AlmCoding/modbus-hbridge/modbus-hbridge-3d/case-top-Body.stl

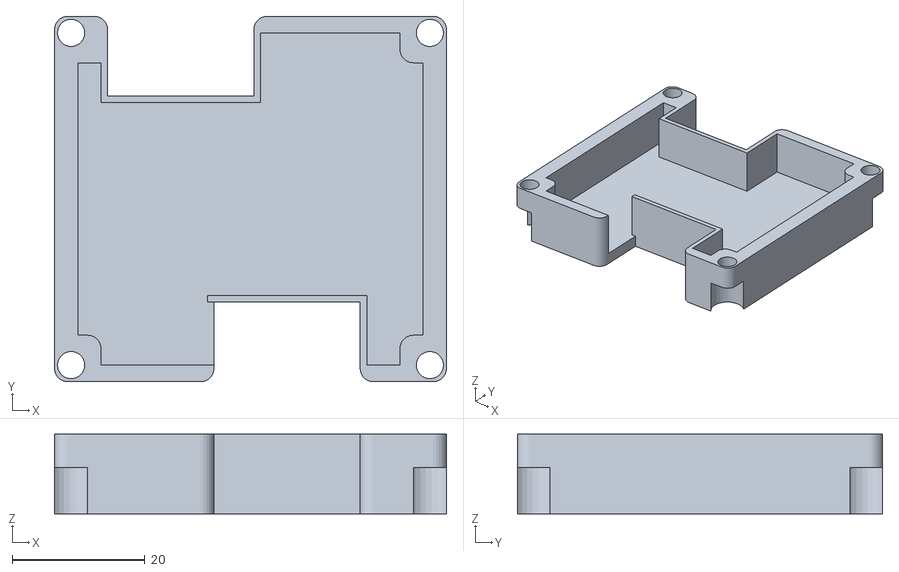
[picture p2: CAD file, 2026-10-08]
modbus-hbridge-3d/case-top-Body.stl
59.0 x 55.0 x 12.0
