AlmCoding/modbus-hbridge/modbus-hbridge-3d/case-bottom-Body.stl

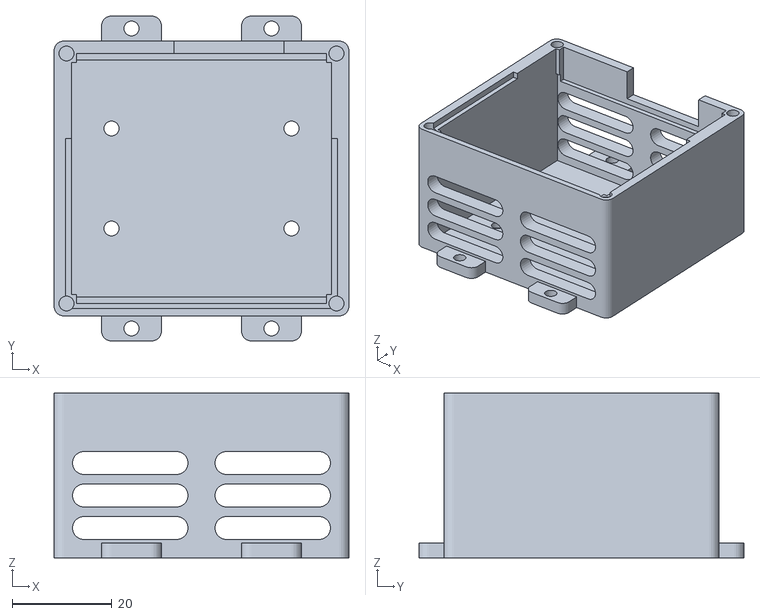
[picture p3: CAD file, 2026-10-08]
modbus-hbridge-3d/case-bottom-Body.stl
59.0 x 65.0 x 33.0
