AlmCoding/modbus-hbridge/(list of files, cad)

Other CAD files:
modbus-hbridge-3d/case-top.FCStd
modbus-hbridge-3d/case-bottom.FCStd
