AlmCoding/modbus-hbridge/modbus-hbridge-hw/modbus-hbridge-hw.kicad_pcb

## KiCad design modbus-hbridge-hw/modbus-hbridge-hw.kicad_pcb (2026-10-08)

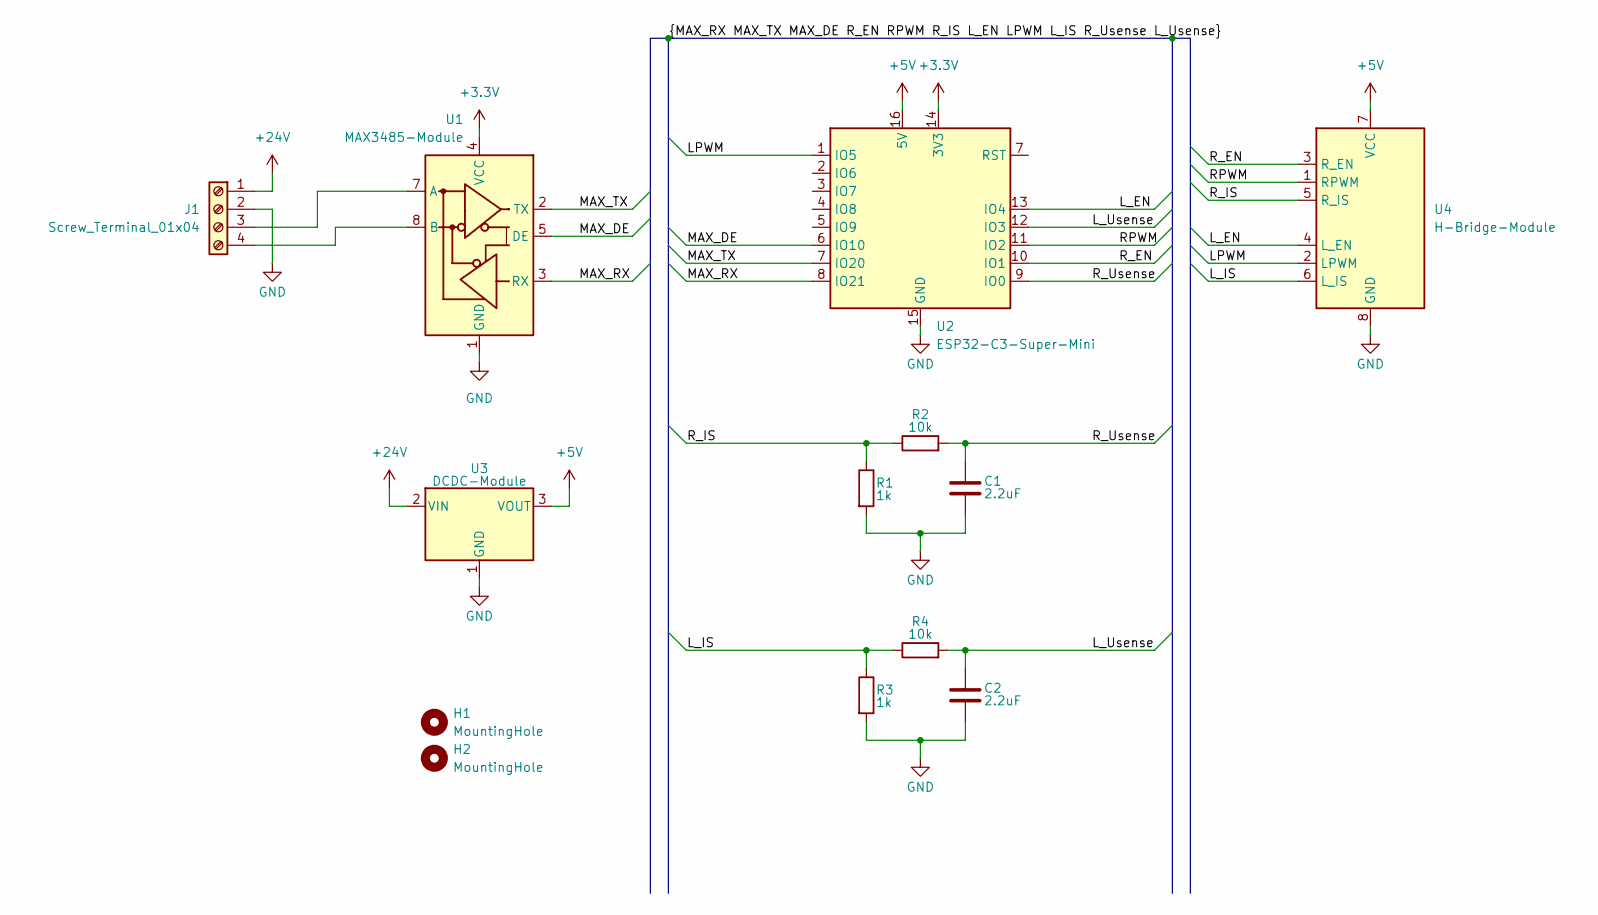
[picture p4: schematic modbus-hbridge-hw.kicad_sch]

Parts:
C1, C2: 2.2uF; C_0603_1608Metric_Pad1.08x0.95mm_HandSolder
H1, H2: MountingHole; MountingHole_3.2mm_M3
J1: Screw_Terminal_01x04; TerminalBlock_CUI_TB007-508-04_1x04_P5.08mm_Horizontal
R1, R3: 1k; R_0603_1608Metric_Pad0.98x0.95mm_HandSolder
R2, R4: 10k; R_0603_1608Metric_Pad0.98x0.95mm_HandSolder
U1: MAX3485-Module
U2: ESP32-C3-Super-Mini; ESP32-C3-SuperMini
U3: DCDC-Module; DCDC-Module-S
U4: H-Bridge-Module

Connections:
+3.3V: U1.4 (VCC), U2.14 (3V3)
+5V: U2.16 (5V), U3.3 (VOUT), U4.7 (VCC)
+24V: J1.1, U3.2 (VIN)
/LPWM: U2.1 (IO5), U4.2 (LPWM)
/L_EN: U2.13 (IO4), U4.4 (L_EN)
/L_IS: R3.1, R4.1, U4.6 (L_IS)
/L_Usense: C2.1, R4.2, U2.12 (IO3)
/MAX_DE: U1.5 (DE), U2.6 (IO10)
/MAX_RX: U1.3 (RX), U2.8 (IO21)
/MAX_TX: U1.2 (TX), U2.7 (IO20)
/RPWM: U2.11 (IO2), U4.1 (RPWM)
/R_EN: U2.10 (IO1), U4.3 (R_EN)
/R_IS: R1.1, R2.1, U4.5 (R_IS)
/R_Usense: C1.1, R2.2, U2.9 (IO0)
GND: C1.2, C2.2, J1.2, R1.2, R3.2, U1.1 (GND), U1.6 (GND), U2.15 (GND), U3.1 (GND), U3.4 (GND), U4.8 (GND)
unnamed: J1.3, U1.7 (A)
unnamed: J1.4, U1.8 (B)

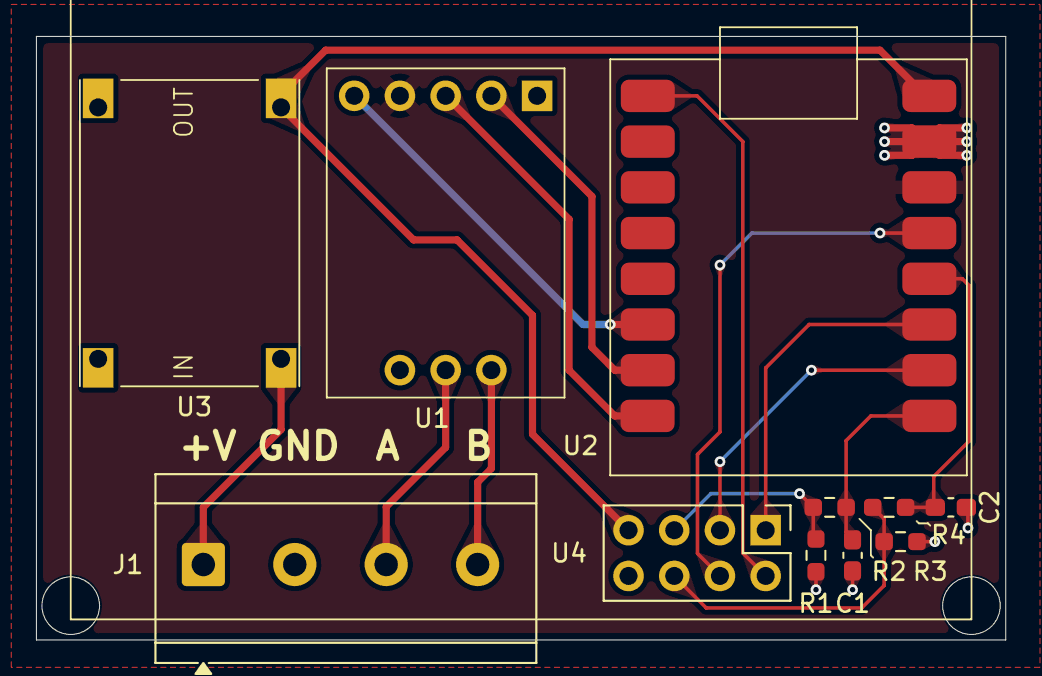
[picture p5: board modbus-hbridge-hw.kicad_pcb from above]

Board: 2 copper layers, 53.8 x 33.5 mm, 13 parts (0 on the bottom side), 17 nets.
