AlmCoding/modbus-hbridge/(commit log)

2026-04-10 Fix PWM resolution
2026-06-16 Prepare current sensing
    [case-bottom.FCStd, case-top.FCStd]
2026-10-08 Add KiCad and FreeCad files
    [case-bottom-Body.stl, case-bottom.FCStd, case-top-Body.stl, case-top.FCStd, modbus-hbridge-hw.kicad_pcb, modbus-hbridge-hw.kicad_sch]
2026-10-10 Add license files
    [case-bottom-Body.stl, case-bottom.FCStd, case-top-Body.stl, case-top.FCStd]
